mdisher/WordClock-MD/(commit log)

2026-07-14 WordClock-MD v1.0 — working ESP32-S3 word clock
    A modernized, fully non-blocking rewrite of johniak/word-clock for the Arduino
    IDE and the ESP32-S3 SuperMini. Captive-portal Wi-Fi setup, mobile dashboard +
    OTA, POSIX-TZ NTP with automatic DST, three color modes, non-blocking
    on-the-hour animations, random-letter status indicator, and a per-frame current
    clamp that keeps the 132-LED WS2812B panel safe on a 5V/3A supply.
    Built, flashed, provisioned, and telling time on real hardware.
    Claude-Session: https://claude.ai/code/session_01MD3Ds6Jux63wxtdDFzKnLW
2026-07-14 docs: direct data path (no level shifter) + white-letters print tip
    - Confirmed the reference build uses NO level shifter; aligned README,
    HARDWARE.md, WordClock-MD/README.md and the SVG wiring diagram to a direct
    GPIO1 -> 330R -> strip DIN path (74AHCT125 demoted to an optional long-run
    fallback everywhere).
    - Added a "physical frame" print tip: use WHITE letters, not clear -- clear
    creates a bright LED center hot-spot -- with the MakerWorld frame model link.
    - Noted the bulk cap as ~940uF (2x470uF).
    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
2026-07-14 Add GPL-3.0 LICENSE + CREDITS attribution
    - LICENSE: canonical GPL-3.0 text, covering the WordClock-MD firmware
    (Copyright (C) 2026 Matt Disher).
    - CREDITS.md: attributes johniak/word-clock (physical frame, serpentine layout,
    English word mapping) and CARVES IT OUT -- the original is unlicensed (all
    rights reserved by its author), so its unmodified copy under wordclock/ is NOT
    covered by this repo's GPL-3.0. Also notes the Espressif datasheet material.
    - README: replaced the credits blurb with a License & credits section pointing
    to LICENSE + CREDITS.md.
    Claude-Session: https://claude.ai/code/session_01MD3Ds6Jux6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
2026-07-14 Add build photo to README; tidy HARDWARE.md ASCII diagram
    - README: add a hero photo of the v1.0 build ("IT IS NINE O'CLOCK", black PLA
    frame with clear letters), with a caption noting the clear-letter hot-spot and
    linking to the white-letters print tip.
    - HARDWARE.md: ASCII wiring diagram reflowed so it no longer wraps and the boxes
    line up better.
    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
2026-07-14 HARDWARE.md: restore left GND injection label + note on both-ends
    - Add back the strip's left-end "GND ●" label so the diagram shows +5V AND GND
    injected at both ends (matching the SVG and connection table).
    - Note that both-ends injection is best practice but wasn't needed on this build.
    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
